2bias2u/Smart-Waste-Sensor/Case/CASE mit Bestigung und Dichtung (nicht final).step

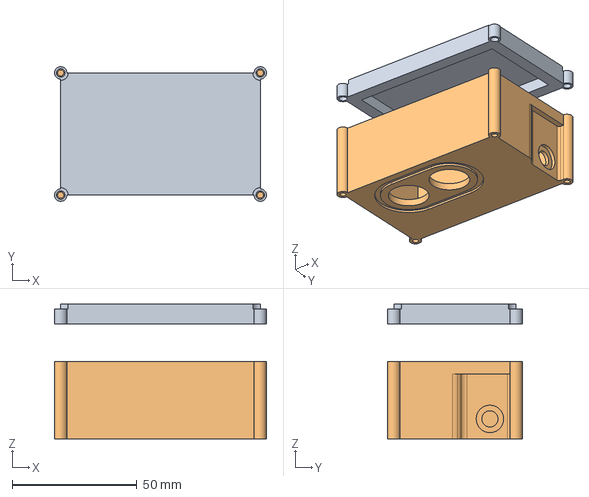
[picture p4: CAD file, 2026-11-12]
Case/CASE mit Bestigung und Dichtung (nicht final).step
85.0 x 54.0 x 54.0 mm
