2bias2u/Smart-Waste-Sensor/(commit log)

2026-07-08 lora32 sendet an TTN
    esp32 läuft in TTN rein
2026-07-08 Anleitung arduino git
2026-07-08 Arduino Git als txt statt rtf
2026-07-09 LiDAR Sensor ESP32 Live Data
    Script liest Sensor in Life Zeit aus
2026-07-09 Update esp32_VL53L3CX_Live.ino
    pin belegung und board nach ergänzt
2026-07-09 Create esp32_VL53L3CX_15s.ino
    Live code angepasst auf alle 15s den Durchschnitt
2026-07-09 Create esp32_VL53L3CX_Tonne.ino
    Scirpt für die Tonne: Seitliche Montage in der Tonne (Winkel einstellbar im Code), Berechnung des Füllstands mit cos
2026-07-09 Create esp32cam_fuellstand_test.ino
    testcode mit helligkeitsunterschieden für messung mit Kameras
2026-08-02 mmwave hex output test
    test ob überhaupt was verknüpftiges ankommt vom sensor
2026-08-02 mmawave
    sendet alle 10 s
    messung vom schreibtisch runter plausibel (Boden Abstand)
    mit Blattpapier dazwischen gleicher Messwert
    mit Plastikdeckel dazwischen gleicher Messwert
    Umzugskarton-Mülleimer:
    mit Pappdeckel: Plausible Ergebnisse (55,x cm)
    mit PD und Beutel (mit Pappe und Tupperdose - ca 7 cm): keine plausible Veränderung
    mit PD und Papierkorb (Behälter Plastik, Inhalt Papier): 5 cm mehr statt 23 cm weniger
    mit PD und Plastikmüllkorb (Behälter Plastik, Inhalt gelber Sack): kein nennswerter Unterschied als ohne
    mit PD und losen Plastikmüll: 55 cm
    --> Umzugskarton Mülleimer auf Erhöhung gestellt: dann Wert bis Boden angezeigt
    ==> durchleuchtete Pappe
2026-08-02 mmwave test
    Test an echten Mülltonnen:
    Sensor auf Deckel:
    Gelbe Tonne: Messwert: 103,x cm / Wert bis Boden: 102 cm / Wert bis Müll: 81 cm
    Papiertonne: Messwert: 101,x cm / Wert bis Boden: 105cm / Wert bis Müll: 55 - 70 cm
    Hausmüll: Messwert: 25cm / Wert bis Boden: 92,5 cm/ Wert bis Müll: 14 - 27 (Inhalt: Plastikrohre siehe Bild 02.08.26 21:14)
    Hausmüll ohne Plastikrohre: Messwert: 26,8 / Wer bis Boden: 92,5 / Wert bis Müll: 25cm
    Biotonne; Messwert: 111,x cm/ Wert bis Boden: 108cm / Wert bis Müll: 95cm
    Regenwassertank: Messwert: 25,8cm / Wert bis Boden:125 / Wert bis Wasseroberkante: 16 cm
    Schnellkonposter; 46 - 50 cm / Wert bis Boden; 104 / Wert bis Müll: 50 cm
    generell sehr anfäl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
2026-08-10 code für combi aus lidar und ultraschall für test
    code für combi aus lidar und ultraschall für test
2026-08-10 verkablung für hx711 in code
    verkablung für hx711 in code
    Sensordrähte an den HX711:
    Sensor 1 Weiß → E+
    Sensor 2 Weiß → E-
    Sensor 1 Rot → A-
    Sensor 2 Rot → A+
2026-09-14 wiegezellen an Tonne
    in kg und x4 weil nur ein rad gemessen wird
    (kalbieren mit absoluten wert )
2026-09-15 Gewichtssensor 2.0
    neuer Sensor gebaut mit https://www.amazon.de/dp/B0D4MG9RKC?ref=ppx_yo2ov_dt_b_fed_asin_title
    liefert sehr gute und stabile Werte
2026-11-12 added case file and dashboard
    [CASE mit Bestigung und Dichtung (nicht final).step]
